marklang1993/CSC.T431.Project/README.md

# CSC.T431.Project
Final Project of Course "Advance System Software".

# Folder Instruction:
Shared: For temporary files or file exchange.<br>
Remote: For UI.<br>
Controller: For motor controller.<br>
Manual: For manuals, including software and hardware.<br>
Hardware: For hardware design documents.<br>
Summary: For submitted project summary.<br>
