marklang1993/CSC.T431.Project/Controller/doc/documentation.tex

\documentclass[12pt]{article}
\pagestyle{empty}

\usepackage[fleqn]{amsmath}
\usepackage{graphicx}
\usepackage{fullpage}

\begin{document}
\begin{center}
\large\bf Advanced System Software \\
Project Documentation\\
\end{center}

\begin{center}
	\text{Part of Controller}\\
\end{center}

\bigskip

\begin{center}
	\begin{tabular}{rl}
	\smallskip
	Update Date:& Oct. 31rd, 2018\\
	\smallskip
	Student ID:& 18M38127\\
	\smallskip
	Name:& LANG, Chen\\
	\end{tabular}
\end{center}

\pagebreak
\bfseries
\begin{enumerate}
	\item Task
	\begin{enumerate}
		\normalfont
		\item LED
		\item Display
		\item WIFI Communication
		\item 10ms Scan
		\item 1ms Motor Drive
	\end{enumerate}

\end{enumerate}

\end{document}
