marklang1993/CSC.T431.Project/Summary/ProjectSummary_AdvancedSystemSoftware.pdf

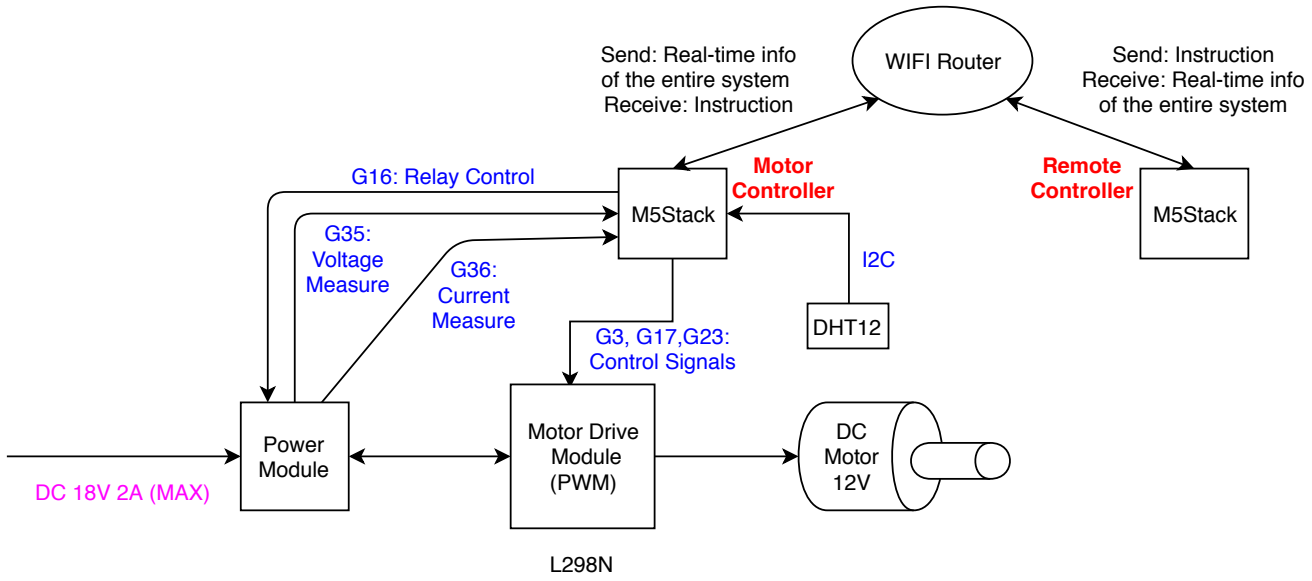
[picture p2: figure]
M5Stack; WIFI Router; Motor Controller; Remote Controller; Power Module; G16: Relay Control; Motor Drive Module (PWM); G35: Voltage; Measure; Current Measure; DC Motor 12V; Send: Real-time info of the entire system Receive: Instruction; Send: Instruction Receive: Real-time info of the entire system; DC 18V 2A (MAX); G3, G17,G23: Control Signals; DHT12
