marklang1993/CSC.T431.Project/Controller/doc/documentation.pdf

### Advanced System Software Project Documentation

Part of Controller

Update Date: Oct. 31rd, 2018 Student ID: 18M38127
Name: LANG, Chen

1

### 1. Task

(a) LED
(b) Display
(c) WIFI Communication
(d) 10ms Scan
(e) 1ms Motor Drive

2
