marklang1993/CSC.T431.Project/Hardware/ASS_HD.pdf

M

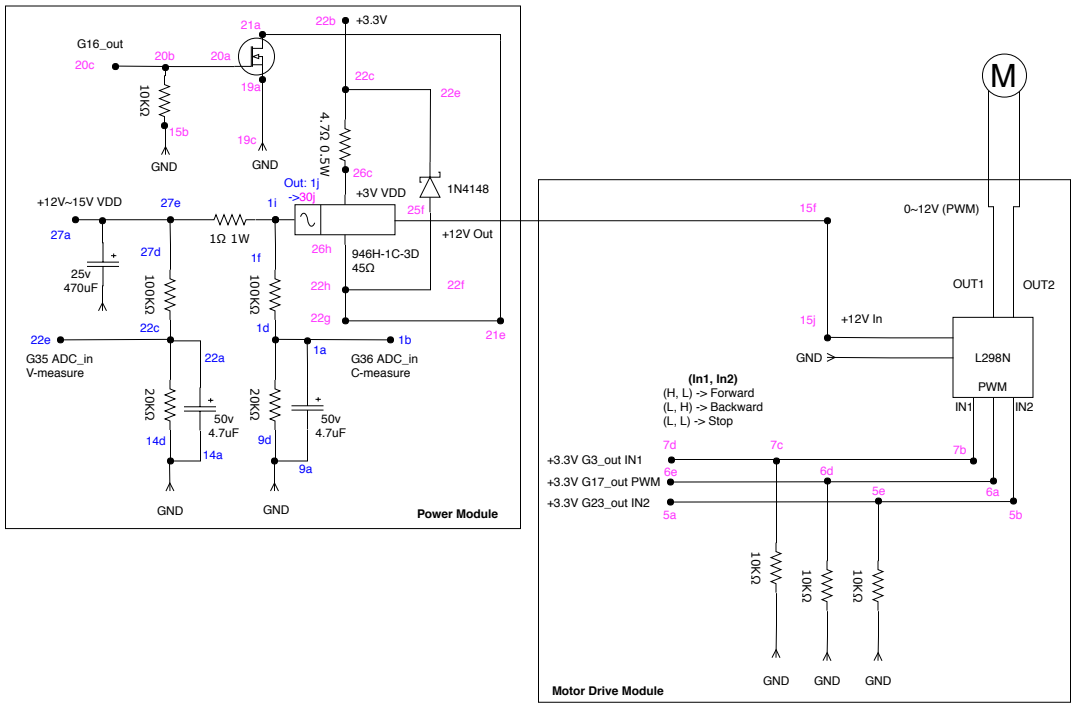
[picture p3: page 1]
+12V~15V VDD; +3V VDD; G16_out; GND; G35 ADC_in V-measure; G36 ADC_in C-measure; Power Module; 0~12V (PWM); OUT1; OUT2; +12V Out; (In1, In2) (H, L) -> Forward (L, H) -> Backward (L, L) -> Stop; +3.3V G3_out IN1; +3.3V G23_out IN2; Out: 1j ->30j; PWM; +3.3V G17_out PWM

Motor Drive Module
