marklang1993/CSC.T431.Project/Remote/main/colorscheme.h

/*
Color scheme from Flat UI Kit: http://www.bootcss.com/p/flat-ui/
PS: Colours need to be transfered from RGB888 to RGB565 which is used in this TFT LCD display.
*/
#define FSSO12 &FreeSansOblique12pt7b
#define FSS12 &FreeSans12pt7b
#define FSS18 &FreeSans18pt7b
#define FSS24 &FreeSans24pt7b
#define FSS9 &FreeSans9pt7b
#define BG_LIGHT 0x324B
#define BG_DARK 0x29EA
#define FRONT_DARK 0x1510
#define FRONT_LIGHT 0x1DF3
#define TEXT_DARK 0xBE18
#define TEXT_LIGHT 0xEF9E
#define GREY_DARK 0x7C71
#define GREY_LIGHT 0x9534
