marklang1993/CSC.T431.Project/Controller/main/port.h

#ifndef _PORT_H
#define _PORT_H_

// All port definitions should be here

// Output Ports
#define LED_PORT        19
#define RELAY_PORT      16

#define IN1_PORT        3
#define IN2_PORT        23
#define PWM_PORT        17

#define SPEAKER_PORT    25      // Used to shut up the speaker

// Input Ports
#define VM_PORT         35      // Voltage measurement
#define CM_PORT         36      // Current measurement

#endif
