marklang1993/CSC.T431.Project/Controller/main/taskDelay.h

#ifndef _TASK_DELAY_H
#define _TASK_DELAY_H

// All delay time should be defined here

#define DELAY_LED               1000
#define DELAY_SCAN              100
#define DELAY_I2C               50
#define DELAY_DRIVE             1

#define DELAY_COMM_WIFI_CONNECT 500
#define DELAY_COMM_CONNECT      1
#define DELAY_COMM_SENDRECV     1

#endif
