marklang1993/CSC.T431.Project/Remote/main/ui.h

/*
This header file contains some functions drawing UI components that can be used in different windows.
*/
#ifndef _H_UI_
#define _H_UI_

void drawButtonBar();
void drawBackground();
void drawRadioOff(int xpos, int ypos);
void drawRadioOn(int xpos, int ypos);

#endif
