marklang1993/CSC.T431.Project/(commit log)

2018-10-31 Controller: Add code structure. Add initial code for LED and WIFI communication.
2018-12-02 Add peripheral circuit diagram.
2018-12-03 Test functions of ADC ports; Add port.h and taskDelay.h
2018-12-03 Modify the circuit diagram: 1. Change Pin1 to Pin22 for IN2; (unable to toggle it) 2. Drive the relay by NMOS.
2018-12-03 Test the functionality of motor drive.
2018-12-03 Add ipc & motor ac/decelerating functions.
2018-12-04 Add ipc for task scan & relay control functionality. Add related code for testing.
2018-12-05 Implement the full functionality of SCAN: 1. Reading voltage; 2. Reading current; 3. Protecting if overcurrent or overvoltage.
2018-12-05 Change IN2 from G22 to G23 since I2C is enabled; Add the framework of getting temperature data.
2018-12-05 Add temperature sensoring functionality.
2018-12-06 fixed flickering on screen 1
    [display.cpp, screen1.cpp]
